Chanula-Maduwantha/Bi-directional-visitor-counter/Solidworks_CAD_files/conceptual Design CAD files/SOLIDOWORKS SKETCHES/Screenshot (521).png

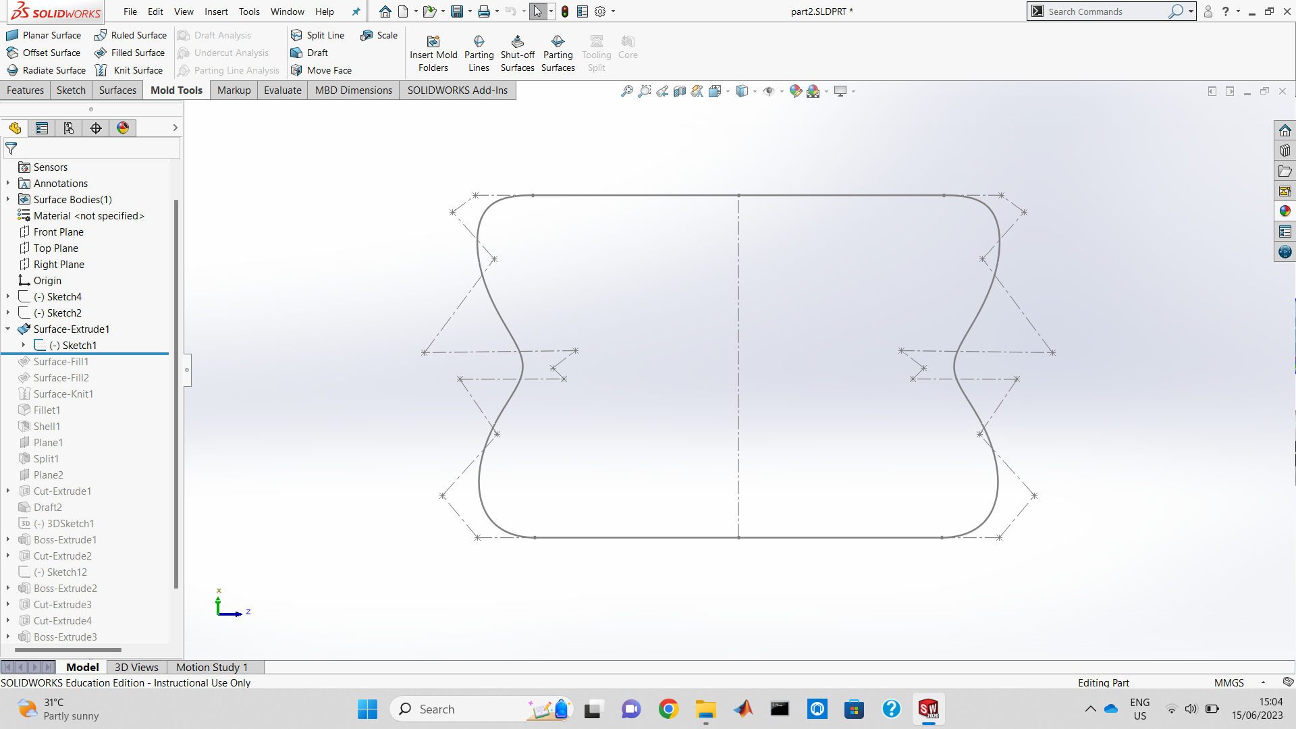
Solidworks_CAD_files/conceptual Design CAD files/SOLIDOWORKS SKETCHES/Screenshot (521).png
