Chanula-Maduwantha/Bi-directional-visitor-counter/Solidworks_CAD_files/conceptual Design CAD files/SOLIDWORKS screenshots/Screenshot 2023-06-15 142633.png

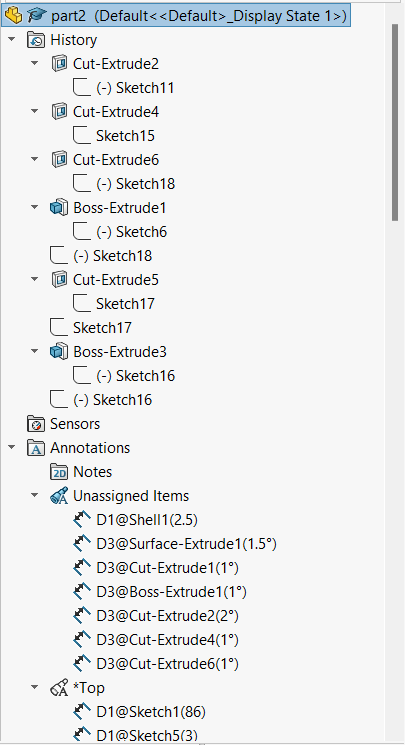
Solidworks_CAD_files/conceptual Design CAD files/SOLIDWORKS screenshots/Screenshot 2023-06-15 142633.png
