Chanula-Maduwantha/Bi-directional-visitor-counter/Solidworks_CAD_files/Design CAD files/Screenshot 2023-06-14 141932.png

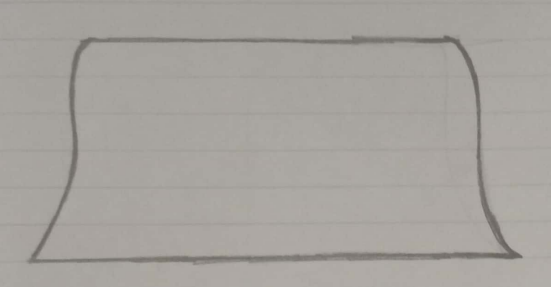
Solidworks_CAD_files/Design CAD files/Screenshot 2023-06-14 141932.png
