Chanula-Maduwantha/Bi-directional-visitor-counter/Solidworks_CAD_files/conceptual Design CAD files/Part1.SLDPRT

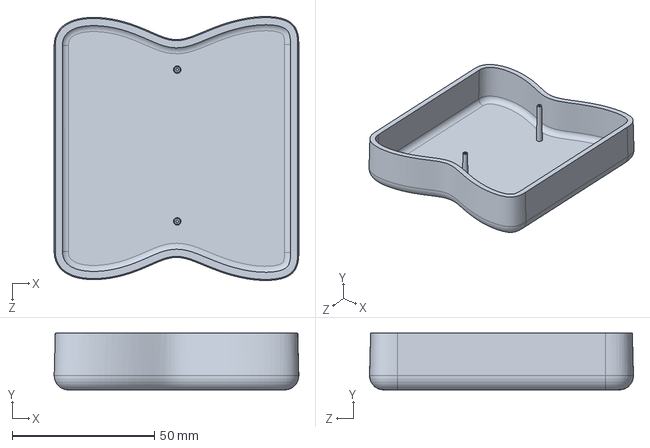
[picture p40: CAD file, 2023-07-24]
Solidworks_CAD_files/conceptual Design CAD files/Part1.SLDPRT
86.0 x 20.0 x 92.8 mm
