Chanula-Maduwantha/Bi-directional-visitor-counter/Solidworks_CAD_files/Design CAD files/Part2.SLDPRT

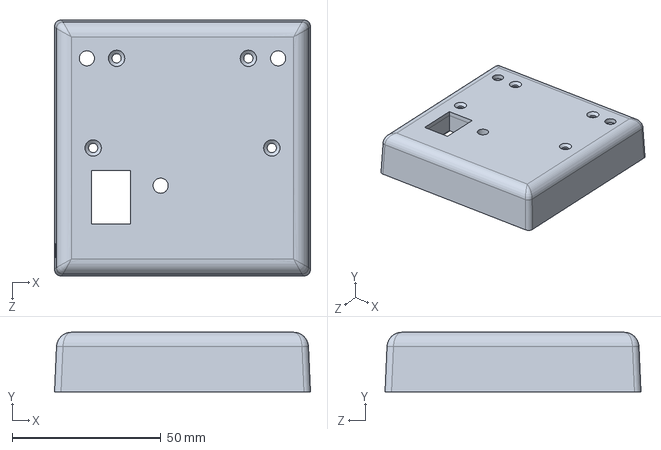
[picture p41: CAD file, 2023-07-24]
Solidworks_CAD_files/Design CAD files/Part2.SLDPRT
86.0 x 20.0 x 86.0 mm
