Chanula-Maduwantha/Bi-directional-visitor-counter/Solidworks_CAD_files/conceptual Design CAD files/part2.SLDPRT

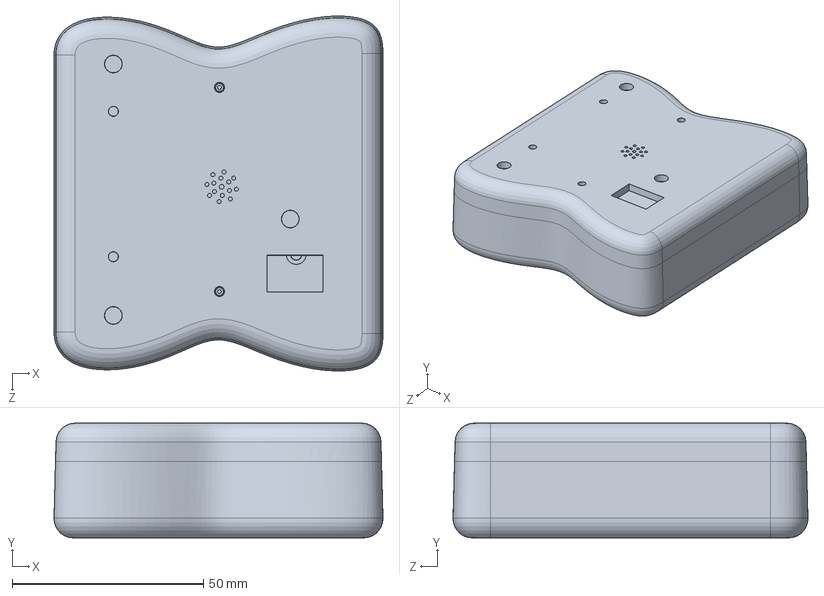
[picture p42: CAD file, 2023-07-24]
Solidworks_CAD_files/conceptual Design CAD files/part2.SLDPRT
86.0 x 30.0 x 92.8 mm
