Chanula-Maduwantha/Bi-directional-visitor-counter/Solidworks_CAD_files/conceptual Design CAD files/PART4 - CAVITY.SLDPRT

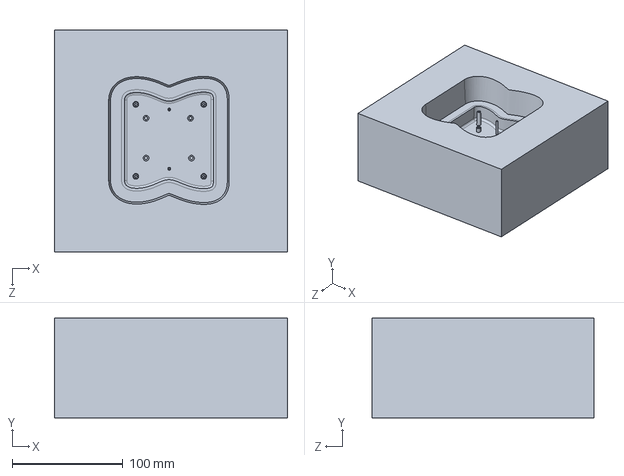
[picture p43: CAD file, 2023-07-24]
Solidworks_CAD_files/conceptual Design CAD files/PART4 - CAVITY.SLDPRT
210.0 x 90.0 x 200.0 mm
