Chanula-Maduwantha/Bi-directional-visitor-counter/Solidworks_CAD_files/Design CAD files/reciever.STL

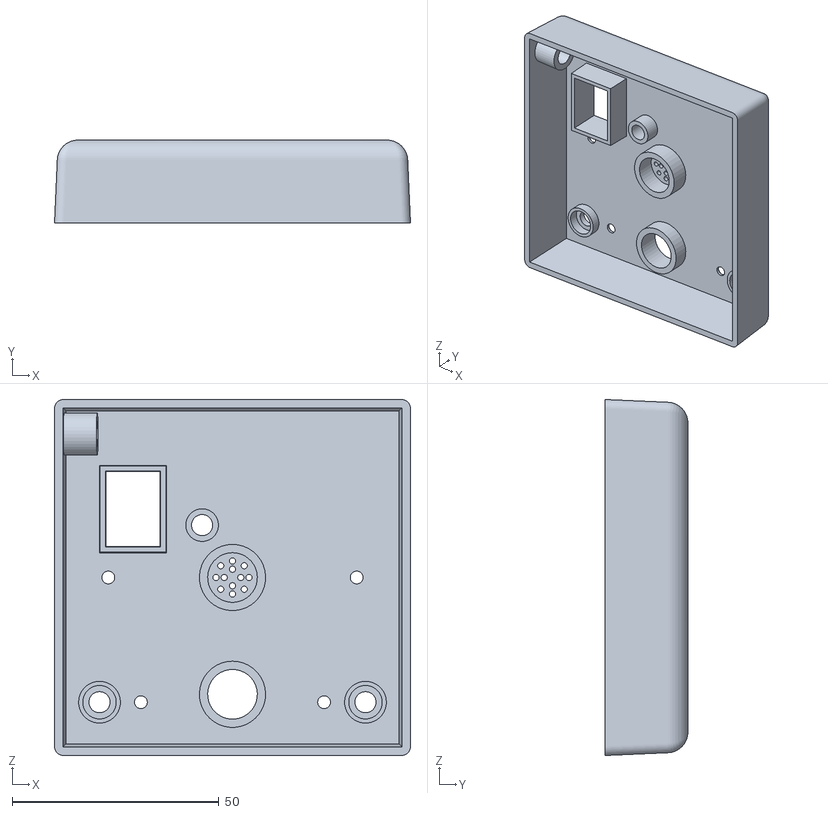
[picture p44: CAD file, 2023-07-24]
Solidworks_CAD_files/Design CAD files/reciever.STL
86.0 x 20.0 x 86.0
