Chanula-Maduwantha/Bi-directional-visitor-counter/Solidworks_CAD_files/conceptual Design CAD files/upper.SLDPRT

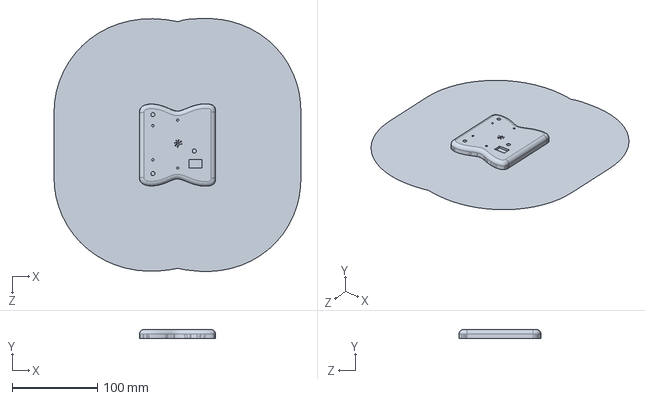
[picture p45: CAD file, 2023-07-24]
Solidworks_CAD_files/conceptual Design CAD files/upper.SLDPRT
289.5 x 10.5 x 296.4 mm
