Chanula-Maduwantha/Bi-directional-visitor-counter/Solidworks_CAD_files/conceptual Design CAD files/PART4 - CORE.SLDPRT

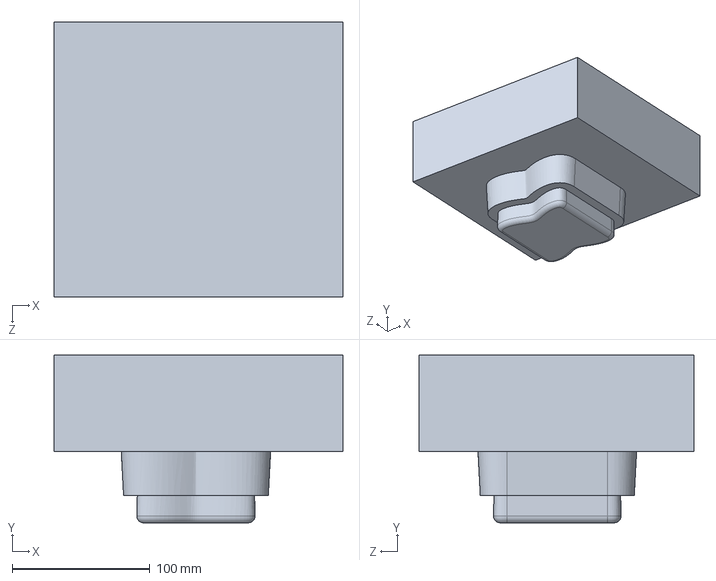
[picture p46: CAD file, 2023-07-24]
Solidworks_CAD_files/conceptual Design CAD files/PART4 - CORE.SLDPRT
210.0 x 121.9 x 200.0 mm
