Chanula-Maduwantha/Bi-directional-visitor-counter/Solidworks_CAD_files/conceptual Design CAD files/PART4.SLDPRT

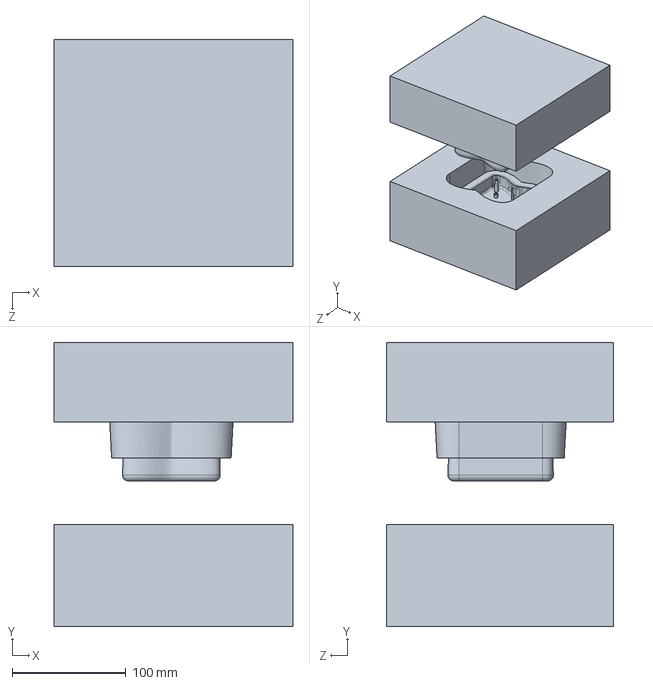
[picture p47: CAD file, 2023-07-24]
Solidworks_CAD_files/conceptual Design CAD files/PART4.SLDPRT
210.0 x 250.0 x 200.0 mm
