Chanula-Maduwantha/Bi-directional-visitor-counter/(list of files, cad)

Other CAD files:
Solidworks_CAD_files/Design CAD files/transmitter.STL
Solidworks_CAD_files/Design CAD files/Part1.SLDPRT
Solidworks_CAD_files/conceptual Design CAD files/transmitter.STL
Solidworks_CAD_files/Design CAD files/Part1.STL
